cfi1513840/TideGauge/Tide Gauge Construction.pdf

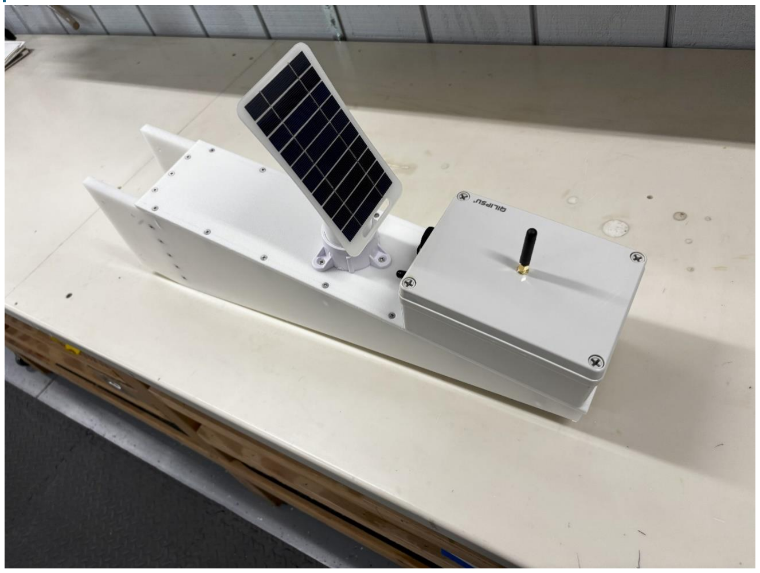
[picture p1: figure]

Ken Howell
1-18-2025

# Tide Gauge Project

## Construction & Deployment

## Contents

## Introduction

The tide gauge is constructed using low-cost components to provide a system to measure and track the tide level at coastal locations. Water-level detection is performed by an ultrasonic (https://maxbotix.com/products/mb7388?_pos=1&_psq=mb7388&_ss=e&_v=1.0) measurement sensor mounted on a small platform, along with a solar panel and LoRa transmitter (https://heltec.org/project/htcc-ab02/) module. The unit is independent of shore power and will operate under normal conditions through all seasons of the year. The platform is intended to be mounted at a dockside location, extending outward about 15”, in a manner that will ensure a clear vertical path from the sensor to the water level under all tidal conditions. The platform is constructed using HDPE material and stainless-steel fasteners to withstand the rigors of the coastal environment. The electronic components are housed within a weatherproof plastic enclosure. The receiving part of the tide gauge should be located within line-of-sight of the transmitting sensor, at distances up to ¼ mile. The receiving location should have access to the internet to provide the necessary online services required by the system. The receiving part of the tide gauge consists of a LoRa receiver (https://heltec.org/project/wifi-lora-32-v3/) and a Raspberry Pi (https://www.amazon.com/Raspberry-Model-2019-Quad-Bluetooth/dp/B07TC2BK1X?th=1) processor to receive and process the measured tide levels, which are then stored in an InfluxDB (https://www.influxdata.com/) database to provide current and historical data access online.
This document describes the fabrication of the tide gauge sensor and transmitting component, and provides instructions for the installation and configuration of all electronic components required to operate the tide gauge.

## Constructing the Platform

## Cutting HDPE to form platform components

The Platform HDPE side supports are cut from ½” material. The overall length of the platform is 24”. The supports are angled from 8” on the wide end to 1” on the narrow end. The wide end can be squared off to a distance of 3 ½” from the end. A plywood jig can be used to maintain a straight cut with the table saw. The bulkhead is cut from ½” material to the dimensions of 3 ½” x 6 ½”. The saw blade should be fine tooth for cutting the HDPE material. The top surface of the platform is cut from ¼” stock to the dimensions of 4 ½” x 20 ½”. The width of the top surface is sized to accommodate the size of the dock mounting post.

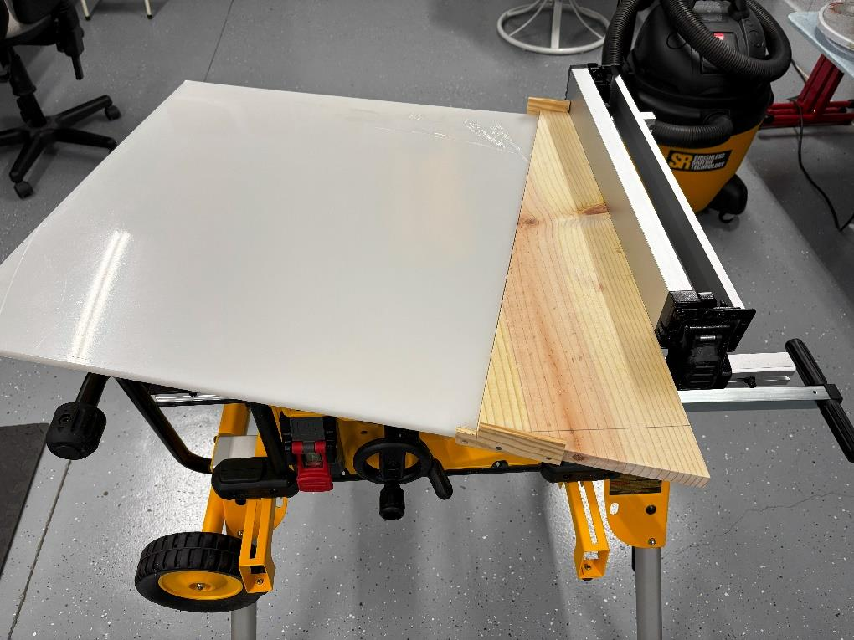
[picture p2: figure]

## Lay Out Hole Patterns

Using a sharpie and straightedge, layout the hole pattern on the side supports. Maintain the top and bottom edge distance as shown. The holes that attach the supports to the bulkhead are at approximately 1” intervals. The bulkhead is attached 3 ½” from the end of the support, which allows mounting on a compatible dockside railing post. To ensure exact orientation, drilling and countersinking should be performed using a drill press. Drill the bulkhead attachment holes using a #31 drill. The larger post/platform mounting holes are drilled using a 15/64” drill to
accommodate the #14 post mounting screws. When countersinking, set the microstop countersink on the light side to start with and progressively add depth until the head of an installed #8 deck screw rests just below the surface of the material.

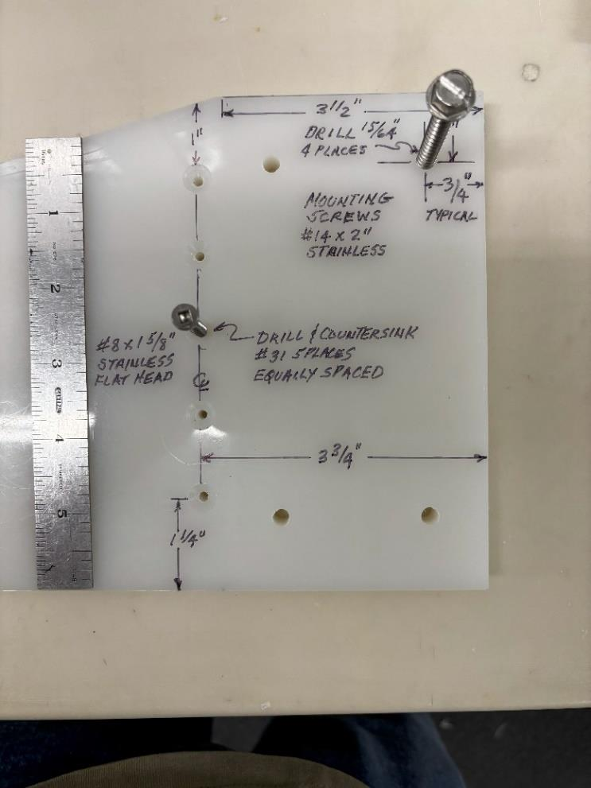
[picture p3: figure]
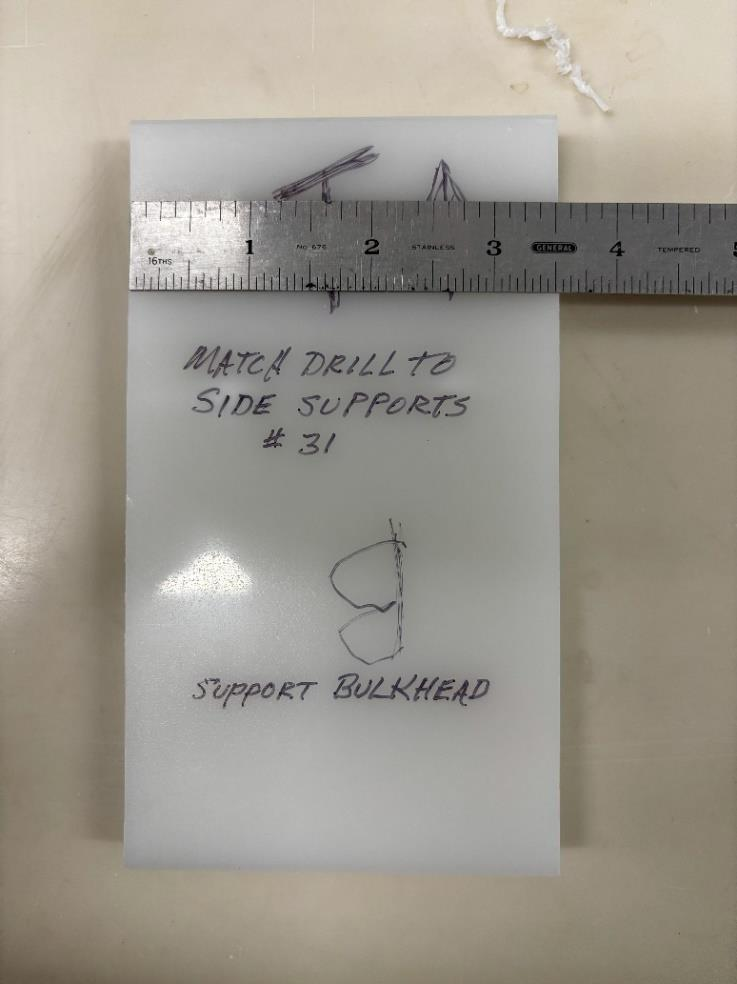
[picture p4: figure]

Note: Sharpie scribe marks and notation can be easily removed with denatured alcohol.

## Assemble Support Structure

With a sharpie, draw vertical lines on the side edges of the bulkhead in the exact center of the material. Clamp the supports and bulkhead assembly together on a flat surface, squaring the bulkhead and ensuring that the predrilled holes in the supports are centered over the bulkhead lines. Using a hand-operated electric drill, carefully match drill the bulkhead to a depth of 1 ½” with a #31 drill. Assemble the platform supports and
bulkhead using #8 x 1 5/8 flathead

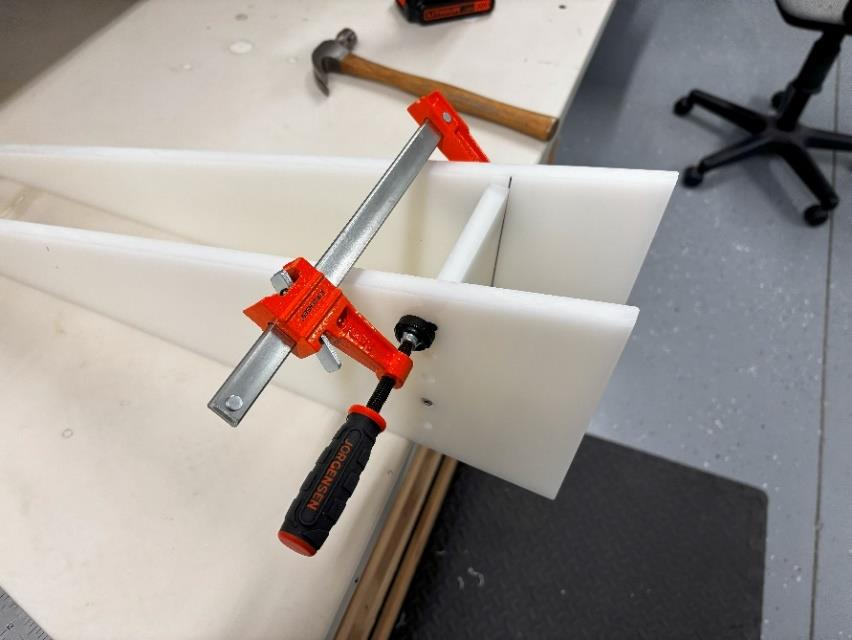
[picture p5: figure]

deck screws.

## Prepare Platform Surface

Layout the hole pattern on the platform top surface ¼” HDPE panel. The holes are spaced about every 3” and should align exactly with the center of the underlying supports. This distance can be exactly determined by measuring across the supports at the bulkhead, from the leading edge of one support to the leading edge of the other. This is the dimension that should be maintained on the top support surface between the scribed lines, with the lines being parallel and equidistant from the edges. The electronics enclosure will be mounted centered at the front of the platform with the forward edge of the enclosure about ¼ - ½” back from the forward edge of the platform. Locate and mark the mounting holes for the equipment enclosure. Note: the holes for the enclosure need to be located precisely as there is minimal edge

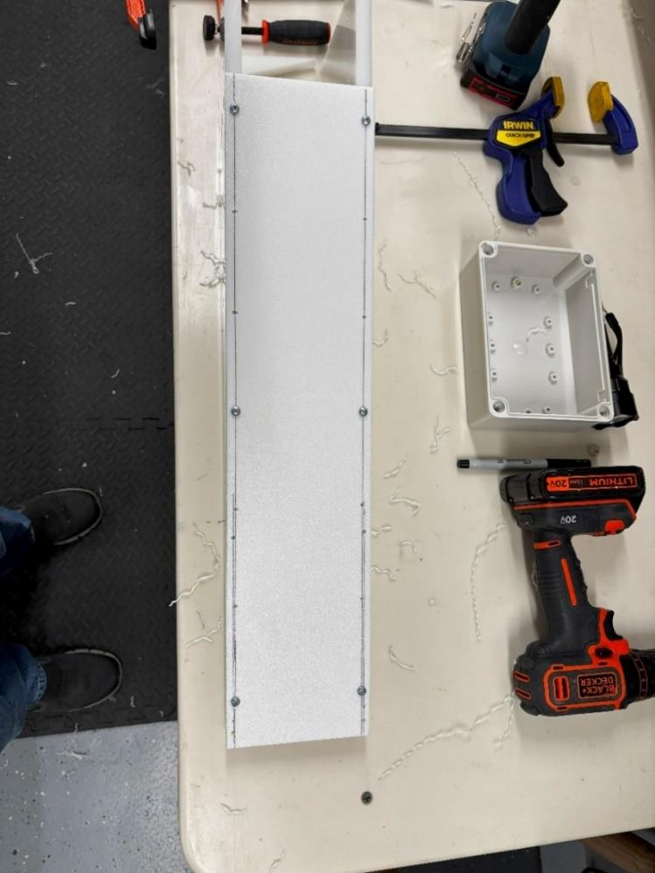
[picture p6: figure]

clearance on the platform surface. Drill and countersink all holes except for the enclosure mounting holes. Although not shown in the photo, there should also be three holes joining the top surface to the bulkhead.

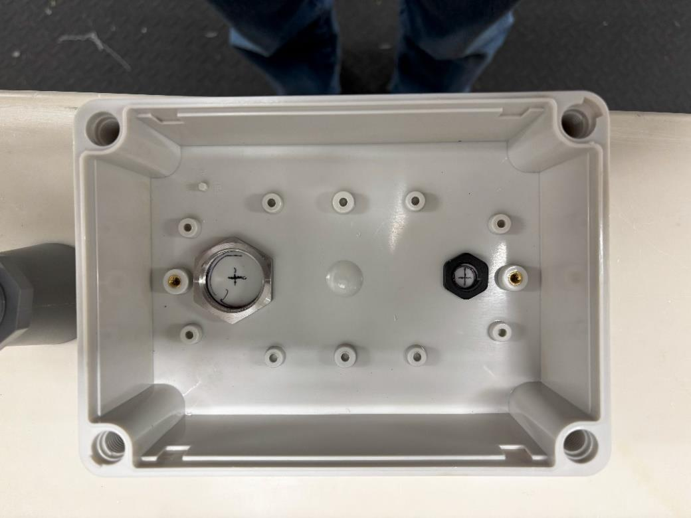
[picture p7: figure]

## Prepare Electronics Enclosure

Layout the holes for the sensor and solar panel wiring on the bottom of the electronics enclosure. Drill 1/8” pilot holes through the bottom of the enclosure. Then install the subpanel and back drill the subpanel through the pilot holes. Finally, while the enclosure is clamped or screwed in place on the platform, drill completely through the subpanel, enclosure and platform mounting surface. Disassemble and enlarge the holes as appropriate.
Note: the enclosure comes with a perforated subpanel, however the hole spacing does not align properly with the mounting holes in either the CubeCell module or PC board. To remedy this, the holes in the existing subpanel can be filled with an epoxy filler, or a new subpanel can be fabricated from 1/8” plastic sheet, using the existing subpanel as a template. For this installation, an epoxy filler was used, consisting of a mixture of West System epoxy and hardener with the addition of microspheres to thicken the mixture to the proper consistency.

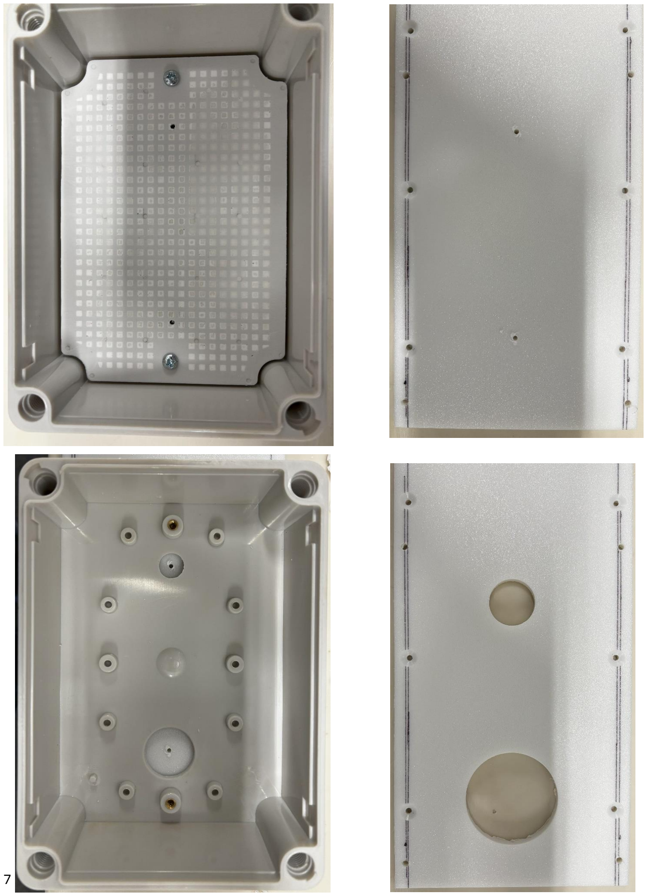
[picture p8: page 8]

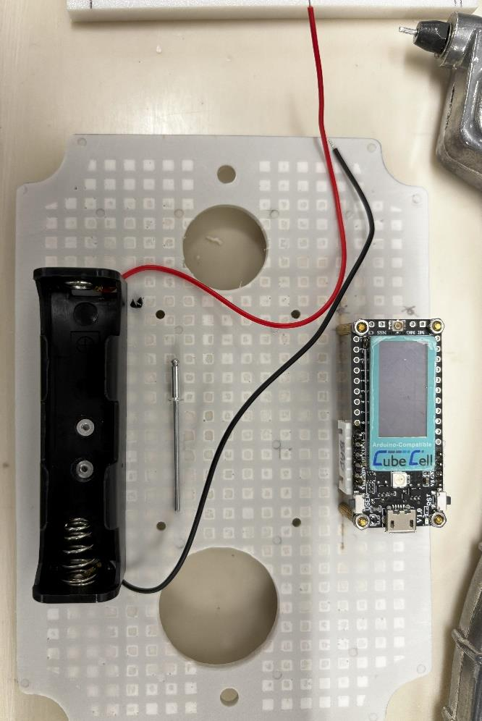
[picture p9: figure]

## Subpanel Component Installation

On the subpanel, layout the locations for the CubeCell, battery holder, and PC board. This can be facilitated by creating templates to transfer the exact hole locations to the subpanel.
Attach the battery holder with flush style pop rivets or other means. If using rivets, the holes in the battery holder should be countersunk. This can be easily accomplished with a small hand countersink tool. The CubeCell and PC board are mounted using 2mm brass standoffs and hardware.
Solder on the CubeCell headers and connect the pre-fabricated CubeCell battery input lead before mounting it on the subpanel. Note: the CubeCell in the top photo was used for layout purposes and does not have the headers installed.
The mounting holes on the CubeCell have minimal radial clearance. For this reason, brass standoff connectors were used to secure the CubeCell.

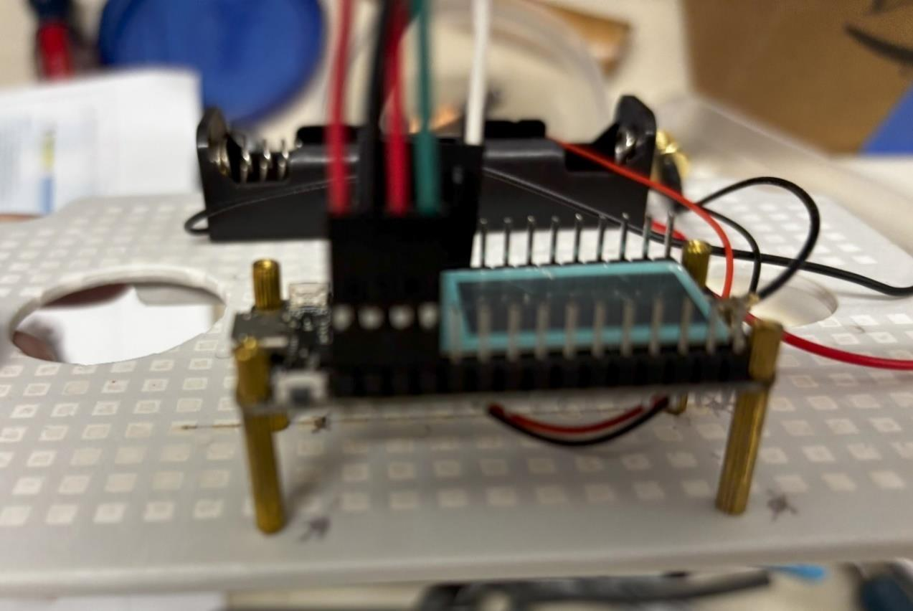
[picture p10: figure]
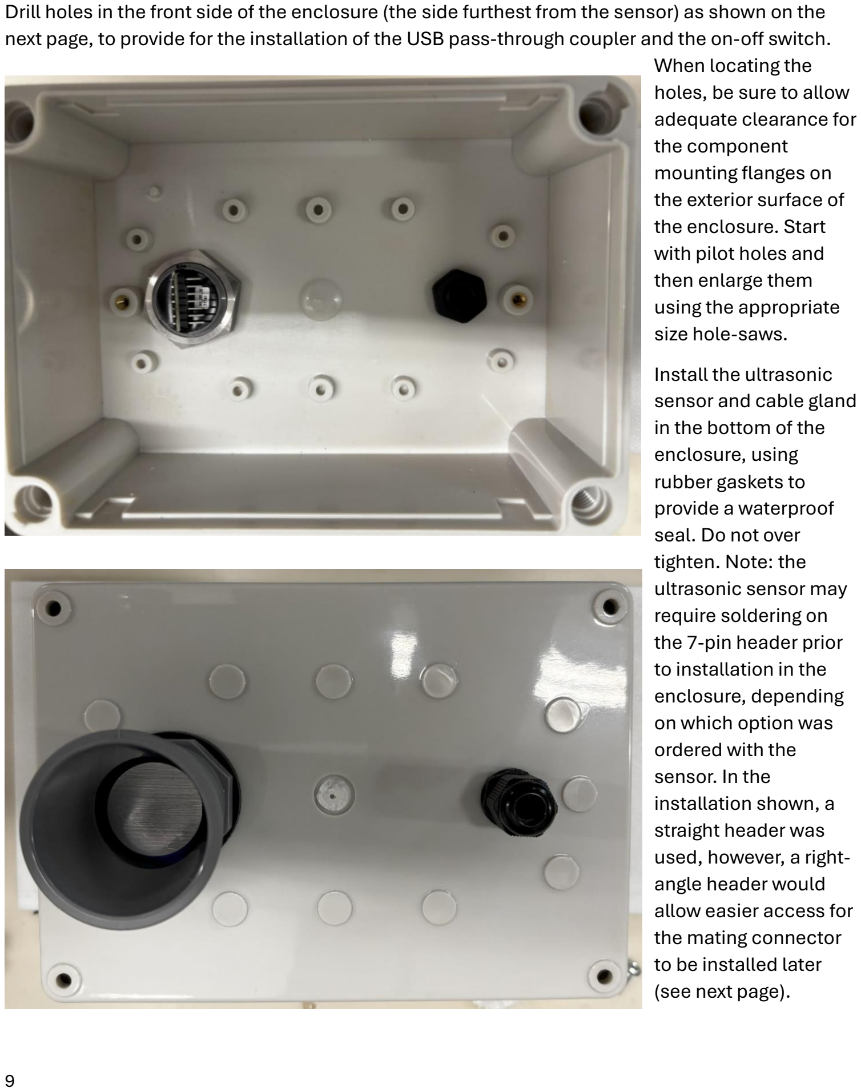
[picture p11: page 10]

Drill holes in the front side of the enclosure (the side furthest from the sensor) as shown on the next page, to provide for the installation of the USB pass-through coupler and the on-off switch. When locating the
holes, be sure to allow
adequate clearance for
the component
mounting flanges on
the exterior surface of
the enclosure. Start
with pilot holes and
then enlarge them
using the appropriate
size hole-saws.
Install the ultrasonic
sensor and cable gland
in the bottom of the
enclosure, using
rubber gaskets to
provide a waterproof
seal. Do not over
tighten. Note: the
ultrasonic sensor may
require soldering on
the 7-pin header prior
to installation in the
enclosure, depending
on which option was
ordered with the
sensor. In the
installation shown, a
straight header was
used, however, a right-angle header would
allow easier access for
the mating connector
to be installed later
(see next page).

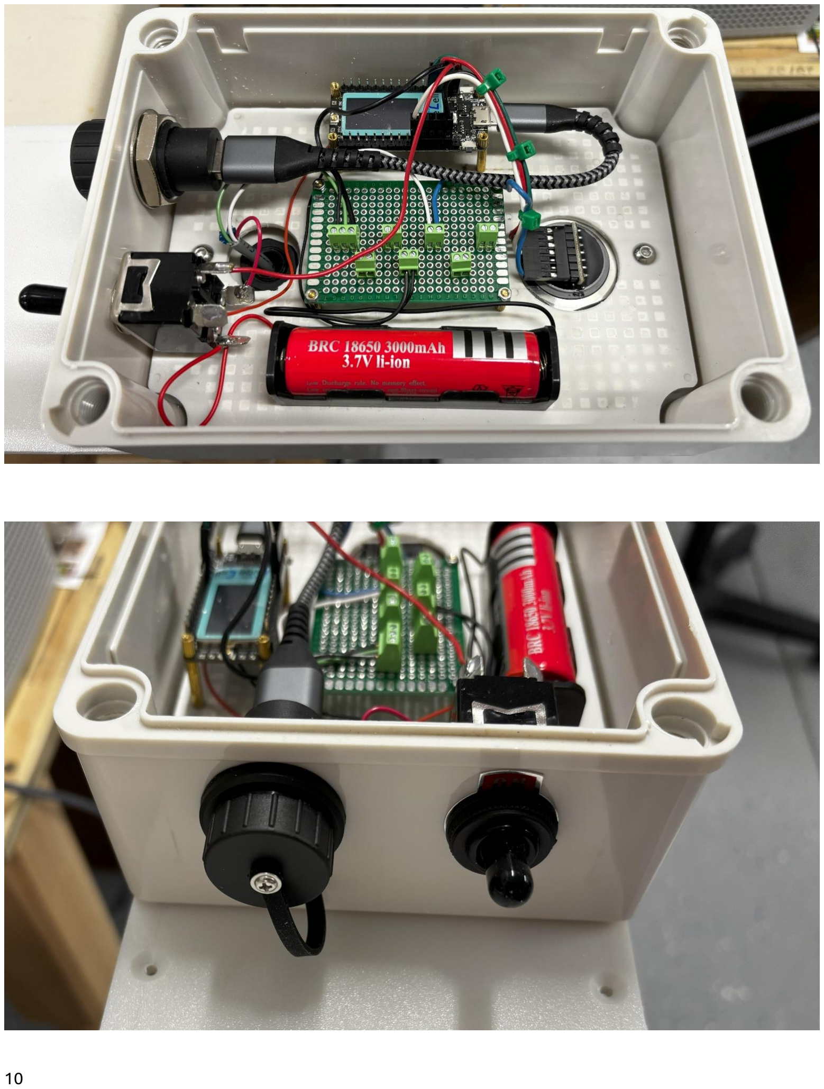
[picture p12: page 11]

## Component Wiring

The PCB and screw terminals are used to facilitate component replacement, if required. Screw terminal leads have soldered jumpers installed on the opposite side of the board. Note that spare terminals were installed but not used. These can be omitted and a smaller PCB used, if desired. Fabricate a wiring harness to interconnect the MaxBotix sensor with the CubeCell. The harness has a 7-pin header connector on the sensor end, four-pin and five-pin connectors on the CubeCell end, and a single wire that will be attached to one of the 2-position screw terminals to interconnect the temperature sensor, which is installed under the platform. Note that not all header pins are used in the connectors. Refer to the Tide Gauge Wiring diagram below to determine the connector pinouts.

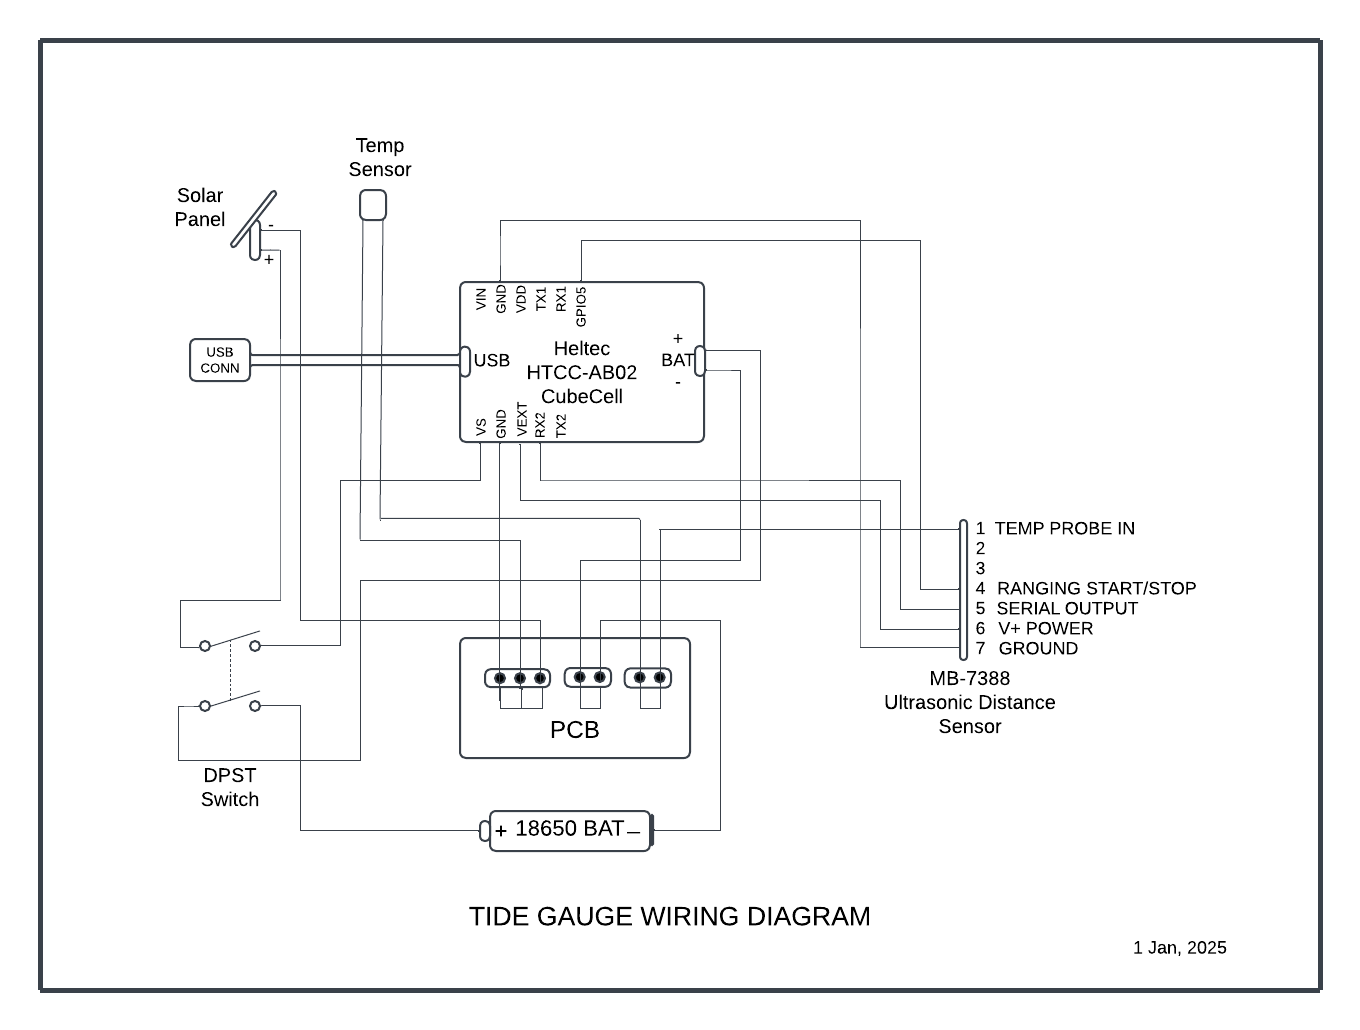
[picture p13: figure]

## Fabricate and Install Solar Panel

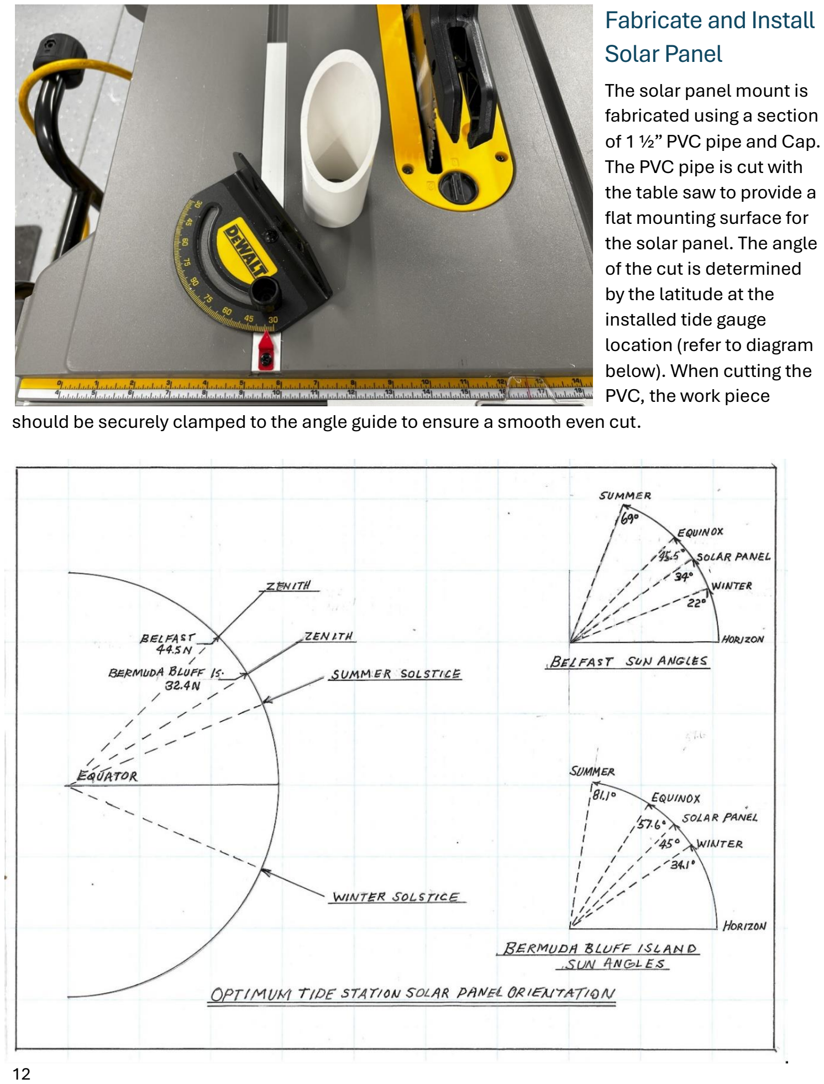
[picture p14: page 13]

The solar panel mount is
fabricated using a section of 1 ½” PVC pipe and Cap.
The PVC pipe is cut with
the table saw to provide a flat mounting surface for
the solar panel. The angle of the cut is determined
by the latitude at the
installed tide gauge
location (refer to diagram below). When cutting the
PVC, the work piece
should be securely clamped to the angle guide to ensure a smooth even cut.

## Attaching Solar Panel to Mounting Post

Note: the solar panel is angled about 12 degrees towards the winter solstice sun angle to compensate for the reduction is winter daylight hours.
To prepare the solar panel for installation, the existing cable should be cut about 8” from the panel and a Molex 2-position micro-fit connector installed. The panel is fitted to the PVC with the panel connections closest to the bottom of the angular cut.
The solar panel is attached to the PVC pipe with plastic glue or epoxy. For this installation, a mixture of West System Epoxy and Hardener was used. To facilitate the attachment, the pipe should be clamped in a vice with the mounting surface adjusted exactly level in both dimensions. Using a cotton swab or similar, the mounting surface of the PVC is liberally coated with the glue or epoxy mixture. This will help to ensure a weatherproof connection between the two parts. Carefully place the panel on the PVC and make sure it is aligned exactly with the pipe (the jaws of the vice can be used for this purpose). Note that the panel is offset vertically such that the panel

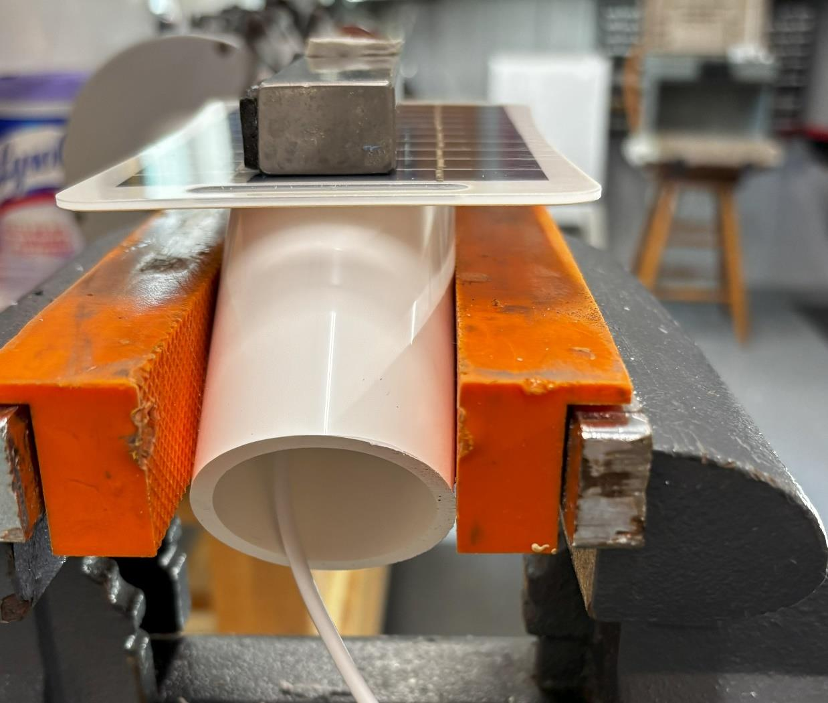
[picture p15: figure]

connections are just enclosed within the bottom of the oval mounting surface. Place a small weight on the top of the panel to ensure a good bond while the epoxy is setting up. Allow 24 hours for setup. In the photo, a small bucking bar is used to secure the panel.

## Install Solar Panel Mounting Base

Drill a 1/8” pilot hole in the PVC cap exactly centered within the inside diameter. Locate the cap on the platform surface about 4 inches from the edge of the enclosure to ensure adequate solar illumination without shadowing. Use the pilot hole to drill through the platform. Enlarge the holes to 1”. Drill the 1/8” mounting holes in the platform surface using the cap as a template. Install the cap using #8 x ½” sheet metal screws.

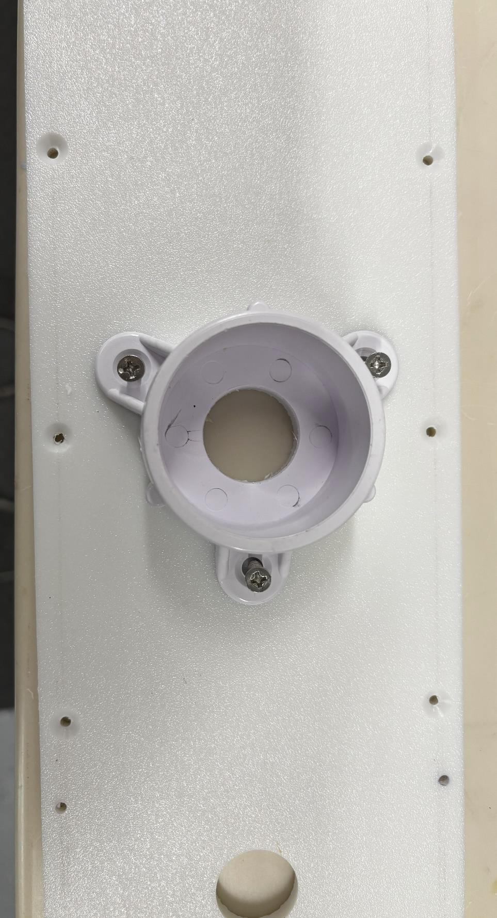
[picture p16: figure]

## Prepare and Install Lower Junction Box

Prepare the small junction box for installation. The box will be attached to the underside of the platform surface, with the center of the box exactly aligned with the PVC cap above. Drill a ½” hole in the bottom center of the box to accommodate a cable gland. With the gland installed, the box should be positioned such that the gland is centered in the PVC cap/platform relief hole. Drill four 5/64” mounting holes as shown in the photo to attach the box to the bottom of the platform surface. Countersink the mounting holes. Drill ½” holes in each side of the box as shown to accommodate the wiring from the temperature sensor and the wiring to the enclosure. Install the cable glands and attach the box to the underside of the platform using #4 x ½” flat head wood screws.

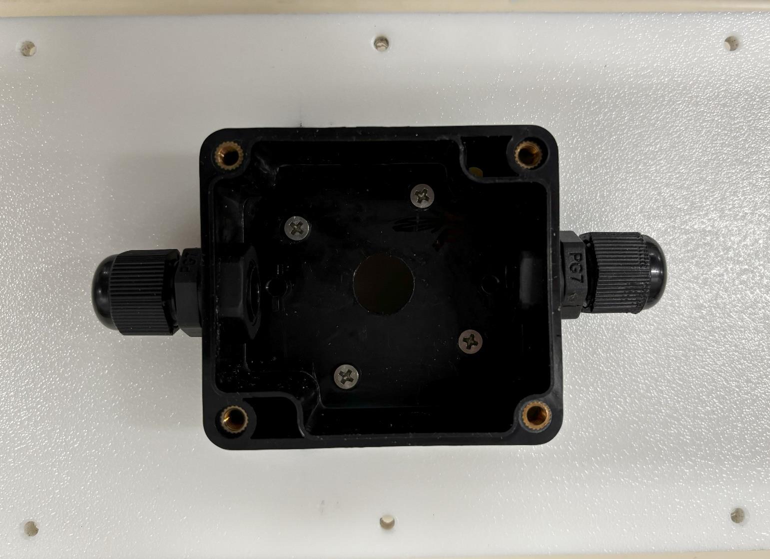
[picture p17: figure]

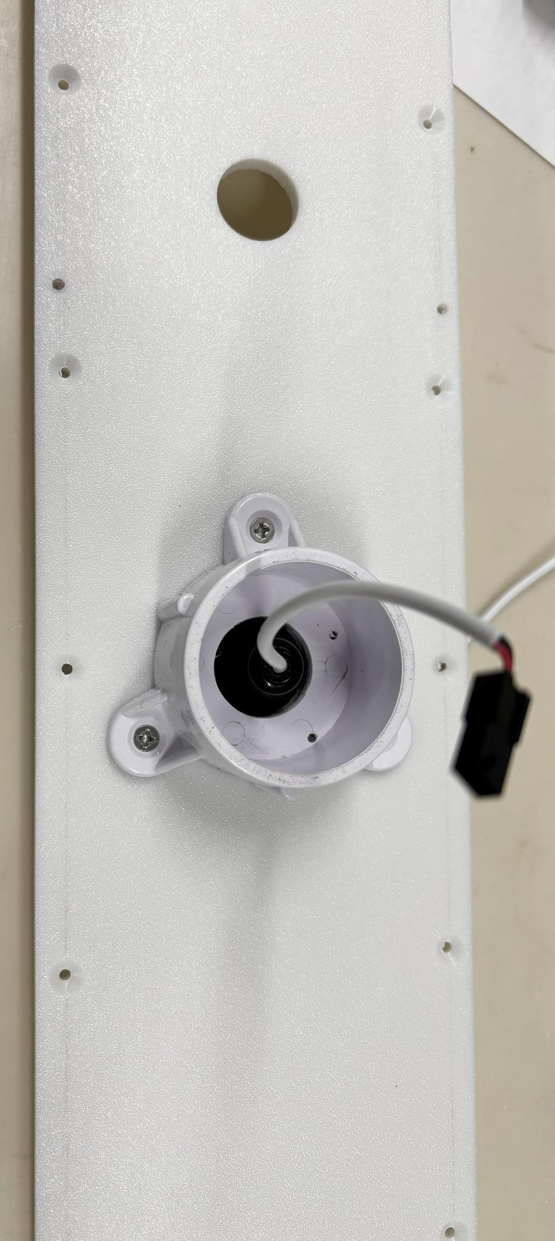
[picture p18: figure]

## Fabricate Solar Panel Connector Cable

Install a 2-conductor cable to connect the solar panel to the interconnect at the junction box. Leave a few inches extending above and below the gland. The end of the cable on the top side has the Molex micro-fit plug installed to mate with the connector on the solar panel. Having the connector in this position will allow easy replacement of the solar panel, if required.
The solar panel is attached by sliding the PVC post into the cap and seating it as far in as possible. A small amount of lubricant is helpful in seating the post. Later, when the sensor is installed at the dock location, a compass will be used to ensure that the solar panel is oriented so that it is pointing towards South. Once the orientation is established, a small hole can be drilled through the post and cap and a “keeper” screw installed.

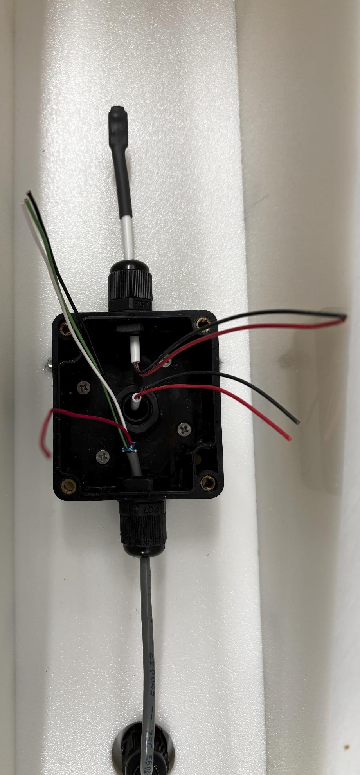
[picture p19: figure]

## Install Temperature Sensor and Interconnect Wiring

Solder the temperature sensor on a short piece of 2-conductor cable and cover the sensor and cable end with a section of shrink tubing. Run the cable through the gland as shown. The sensor and cable are supported by the cable gland and require no further support. Strip back the cable sheath leaving a few inches of wire exposed.
Run the 4-conductor interconnect cable from the junction box to the enclosure through the cable glands. Strip back the cable sheath as above. Splice the solar panel and temperature sensor wiring to the interconnect cable in accordance with the wiring diagram. For this installation, Hilitchi wire connectors (https://www.amazon.com/Connector-Uvital-Waterproof-Gel-Filled-Connectors/dp/B07Z7NY6BN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) were used.

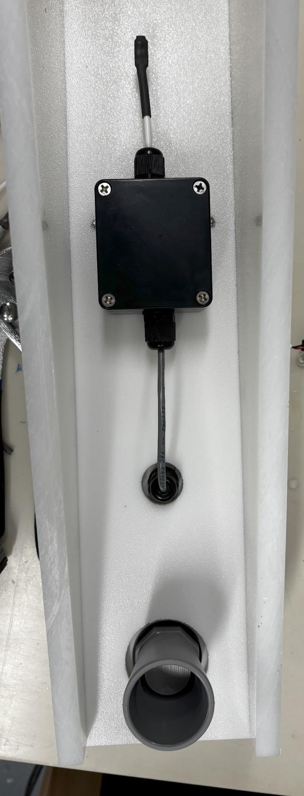
[picture p20: figure]

## Underside view of finished Tide Gauge

## Programming the Heltec LoRa Modules

## Module Description

The Heltec HTCC-AB02 CubeCell and WiFi LoRa 32(v3) modules provide the capability of reading, processing, transmitting and receiving tide level measurements to support the tidal data acquisition process. These modules have a broad range of capabilities, however, only the functions associated with the serial interface, processing, and transmitting LoRa data are utilized. To conserve power the OLED display and WiFi functions will remain inactive.

## Module Interconnectivity

The HTCC-AB02 CubeCell connects to the ultrasonic sensor via its serial interface to read, process and forward distance (water level) measurement data to the receiving WiFi LoRa 32(V3) module. To conserve power, the sensor is operated in the “triggered” mode and is activated for only 20 seconds out of every minute, with the remainer of the time being placed in the “sleep” mode. During the active period, 20 measurements are taken at one second intervals. This sampling scheme helps to ensure an accurate measure of the tide level, while averaging out the effects of chop or wave action. The built-in triggering function is activated by applying a signal on Pin 4 on the sensor. Measured values in the form of text messages are output on the sensor serial output pin 5. The CubeCell performs error checking and filtering of the data prior to LoRa transmission. Measurements are transmitted in the form of text-formatted packets containing the measurement values and associated meta data, such as battery voltage, etc.

## Module Processing

The receiving WiFi LoRa 32(V3) module receives and outputs the data to a Raspberry Pi 4 (RPi4) processor, which in turn, writes the data to an InfluxDB database for both local and online storage. Note that the HTCC-AB02 CubeCell module is normally capable of providing both the LoRa transmit and receive capability. However, a problem was discovered which caused the USB interface between the receiving CubeCell and the RPi4 to stop functioning at random intervals. This problem required manual rebooting or restarting the RPi4. The problem was alleviated by substituting the WiFi LoRa 32(V3) module to perform the receiving function.

## The Arduino IDE

The Heltec units are among a variety of modules that are supported by the Arduino Integrated Development Environment (IDE). The Arduino IDE is open-source software that can be downloaded and installed under the Windows, Linux, or macOS operating systems. There are also pre-programmed libraries available to support both Heltec modules. During development of the tide gauge, certain incompatibilities were noted between the Heltec libraries and the latest IDE version 2.3.4. For this reason, it is recommended to download and install the IDE legacy version

2.3.2, which can be found at the URL Release 2.3.2 · arduino/arduino-ide · GitHub. (https://github.com/arduino/arduino-ide/releases/tag/2.3.2) The version corresponding to the platform in use (PC, Mac) should be downloaded and installed.

## Module Software Program Format

The software programs that run on the Heltec devices are referred to as “sketches”. These are C language programs that have the unique file type of “.ino”. Once a sketch has been prepared, it is compiled by the IDE using the appropriate library files and downloaded to the Heltec module via the USB connection between the IDE platform and the module.

## Module Framework and Library Description

When configuring the Arduino IDE, the device framework and library modules required to support each specific device are downloaded. Refer to Heltec ESP32 Series Quick Start — esp32 latest documentation (https://docs.heltec.org/en/node/esp32/esp32_general_docs/quick_start.html) for additional information.
For the HTCC-AB02 CubeCell and WiFi LoRa 32(v3) modules, the supporting framework and libraries listed below are required. Some of the libraries may not relate directly to the functions utilized but are required as dependencies of other library modules. The Arduino IDE incorporates two different levels of device support. The device framework is provided by the Boards Manager, whereas additional functional device support is provided by the Library Manager. The Boards and Library Manager utilities are accessed via the IDE menu options.

## Module Framework and Library Installation

The Arduino IDE File->Preferences menu option is used to download the CubeCell Development framework and the WiFi LoRa ESP32(v3) framework. This is accomplished by adding the following URL’s to the Additional boards manager URL’s:
1. https://github.com/HelTecAutomation/CubeCell-Arduino/releases/download/V1.5.0/package_CubeCell_index.json. (https://github.com/HelTecAutomation/CubeCell-Arduino/releases/download/V1.5.0/package_CubeCell_index.json)
2. https://resource.heltec.cn/download/package_heltec_esp32_index.json
When the URL’s have been added, the OK button is selected to initiate the download.
Once the download is complete, the Boards Manager panel should show entries for “CubeCell Development Framework by Heltec” and “Heltec ESP32 Series Dev-boards by Heltec”, both of which are then installed with the corresponding INSTALL button.
The libraries are then installed through the Arduino IDE Library Manager. From the Library Manager panel, search for and install the following:
1. ESP8266 and ESP32 OLED driver for SSD1306…
2. Heltec ESP32 Dev-Boards by Heltec…
3. Heltec ESP8266 Dev-Boards by Heltec…
4. Heltec_ESP32_LoRa_v3 by Rop Gongrijp

5. Heltec_LoRa_OLED_Examples by GregLee
6. HotButton by Ron Gongrijp
7. RadioLib by Jan Gromes
Note: Items 6 and 7 are normally
downloaded as dependencies for other modules.

## Module Sketch, Board and Port Selection

With the framework and libraries installed, the Arduino IDE menu option Tools->Board can be selected to view a dropdown menu containing the board types. This menu is followed to select the board framework matching the connected board to be programmed.
The Arduino IDE menu option File->Examples can be used to load board-specific example sketches that are tailored to perform specific functions, for example LoRa transmit and receive. This is a good starting point for sketch development, and the way the tide gauge sketches were initially created.
When the USB connection has been established with the board, the appropriate Comm Port connection should be displayed on the pull-down in the board display area of the IDE.

## Appendix A – Tide Gauge – Parts List and Cost Analysis

Item Nbr | Description | Total Cost | Percentage used by project | Project Cost | Receiving Station
1 | 24" x 48" x 1/2" HDPE Panel (https://www.amazon.com/gp/product/B0CC58C836/ref=ppx_yo_dt_b_search_asin_title?ie=UTF8&th=1) | 87.99 | 25 | 22.00
2 | 24" x 48" x 1/4" HDPE Panel (https://www.amazon.com/gp/product/B0BYPD4XYV/ref=ppx_yo_dt_b_search_asin_title?ie=UTF8&th=1) | 65.99 | 25 | 16.50
3 | 24" x 24" x 1/8" Plastic Sheet (https://www.amazon.com/gp/product/B00BCPYPLM/ref=ppx_yo_dt_b_search_asin_title?ie=UTF8&psc=1) | 15.36 | 25 | 3.84
4 | #4 x 1/2" Flat Head Wood Screws (https://www.amazon.com/gp/product/B07H2ZJLCF/ref=ppx_yo_dt_b_search_asin_title?ie=UTF8&psc=1) | 12.31 | 10 | 1.23
5 | #8 x 1" Pan Head Sheet Metal Screws (https://www.amazon.com/gp/product/B01CEZSJB0/ref=ppx_yo_dt_b_search_asin_title?ie=UTF8&th=1) | 15.16 | 4 | 0.61
6 | #6 x 1 1/4" Deck Screws (https://www.amazon.com/gp/product/B018UPHUTU/ref=ppx_yo_dt_b_search_asin_title?ie=UTF8&psc=1) | 14.95 | 10 | 1.50
7 | #8 x 1 5/8" Deck Screws (https://www.amazon.com/gp/product/B0CVZSBWCN/ref=ppx_yo_dt_b_search_asin_title?ie=UTF8&psc=1) | 14.49 | 20 | 2.90
8 | #8 x 1/2" Flat Head Wood Screws (https://www.amazon.com/Screws-Phillips-Stainless-Quantity-Fastenere/dp/B01MCWTEX4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) | 14.48 | 3 | 0.43
9 | #14 x 2" Hex Washer Head Screws (https://www.amazon.com/Stainless-Washer-Drilling-Screws-Tapping/dp/B076BWXDD3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) | 15.99 | 20 | 3.20
10 | 3/32" Aluminum Blind Rivets (https://www.amazon.com/ALUMINUM-BLIND-COUNTERSUNK-031-125-PIECES/dp/B01MUF5Y0V?gQT=1) | 18.43 | 2 | 0.37
11 | QILIPSU Outdoor Junction Box (6.9"x4.9"x3") (https://www.amazon.com/gp/product/B0CSG54SYW/ref=ppx_yo_dt_b_search_asin_title?ie=UTF8&th=1) | 13.49 | 100 | 13.49
12 | Zulkit Project Box (2.48"x2.28"x1.38") (https://www.amazon.com/gp/product/B07SBWQL18/ref=ppx_yo_dt_b_search_asin_title?ie=UTF8&th=1) | 6.59 | 100 | 6.59
13 | QILIPSU 1/2" NPT Cable Glands (https://www.amazon.com/QILIPSU-Waterproof-Adjustable-Locknut-Diameter/dp/B07ZRH3V59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) | 8.99 | 33 | 2.97
14 | PVC Table Leg Cap (https://www.amazon.com/gp/product/B0CFLN8QG3/ref=ppx_yo_dt_b_search_asin_title?ie=UTF8&th=1) | 7.59 | 50 | 3.80
15 | PVC Pipe, 1 1/2" (https://www.amazon.com/gp/product/B085B4YW2T/ref=ppx_yo_dt_b_search_asin_title?ie=UTF8&psc=1) | 31.99 | 5 | 1.60
16 | Solar Panel (https://www.amazon.com/gp/product/B0CWGW8Q3D/ref=ppx_yo_dt_b_search_asin_title?ie=UTF8&psc=1) | 16.03 | 100 | 16.03
17 | MaxBotix MB7388 Ultrasonic Distance Sensor (https://maxbotix.com/products/mb7388) | 119.95 | 100 | 119.95
18 | Heltec HTCC-AB02 LoRa CubeCell Module (https://heltec.org/project/htcc-ab02/) | 15.50 | 100 | 15.50
18 | Heltec WiFi LoRa 32(V3) (https://heltec.org/project/wifi-lora-32-v3/) | 19.90 | 100 | | 19.90
19 | Raspberry Pi 4 (https://www.amazon.com/CanaKit-Raspberry-4GB-Starter-Kit/dp/B07V5JTMV9) | 119.99 | 100 | | 119.99
20 | Brass Standoff Kit (https://www.amazon.com/gp/product/B09X3F9D1D/ref=ppx_yo_dt_b_asin_title_o00_s00?ie=UTF8&th=1) | 15.99 | 5 | 0.80
21 | Printed Circuit Board (https://www.amazon.com/Rindion-Compatible-Prototype-Electronics-Soldering/dp/B0DBZ1BXFZ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) | 6.99 | 5 | 0.35
22 | 18650 Battery Holder (https://www.amazon.com/DIANN-10pcs-Battery-Holder-Single/dp/B0BJV7SK5D?s=electronics) | 5.99 | 10 | 0.60
23 | 18650 Battery (https://www.amazon.com/WZXLifeScult-Universal-Doorbells-Flashlights-Headlamps/dp/B0D479CCVK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) | 19.89 | 25 | 4.97
24 | Waterproof Double Pole, Single Throw Switch (https://www.amazon.com/gp/product/B082QNPQSW/ref=ppx_yo_dt_b_search_asin_title?ie=UTF8&psc=1) | 13.99 | 33 | 4.62
25 | Waterproof USB Coupler (https://www.amazon.com/gp/product/B09VNS64HM/ref=ppx_yo_dt_b_search_asin_title?ie=UTF8&th=1) | 16.99 | 100 | 16.99
26 | Micro USB to USB Cable, 6" (https://www.amazon.com/SUNGUY-Braided-Charging-Samsung-Android/dp/B0BHNVLW1Z) | 7.99 | 33 | 2.64
27 | Molex Micro-fit Receptacle, 2 position (https://www.digikey.com/en/products/detail/molex/0436450200/268974?s=N4IgTCBcDaIO4FsCMAOALAVgLQDsAmIAugL5A) | 0.31 | 100 | 0.31
28 | Molex Micro-fit Plug, 2 position (https://www.digikey.com/en/products/detail/molex/0436400201/268984?s=N4IgTCBcDaIO4FsCMAOArGgtAOwCYgF0BfIA) | 0.33 | 100 | 0.33
29 | Molex Micro-fit Connector Socket 20-24AWG (https://www.digikey.com/en/products/detail/molex/0430300009/252481) | 0.15 | 100 | 0.15
30 | Molex Micro-fil Connector Pin 20-24AWG (https://www.digikey.com/en/products/detail/molex/0430310009/252485) | 0.19 | 100 | 0.19
31 | Header Connector Kit (with crimping tool) (https://www.amazon.com/gp/product/B0C6PM9KGY/ref=ppx_yo_dt_b_search_asin_title?ie=UTF8&psc=1) | 26.99 | 5 | 1.35
32 | Screw Terminal Block Connectors (https://www.amazon.com/gp/product/B09F6TC7RP/ref=ppx_yo_dt_b_search_asin_title?ie=UTF8&psc=1) | 14.99 | 10 | 1.50
33 | Wire Connectors (https://www.amazon.com/Connector-Uvital-Waterproof-Gel-Filled-Connectors/dp/B07Z7NY6BN?th=1) | 14.99 | 2 | 0.30
34 | 22AWG Wire (https://www.amazon.com/Electric-Flexible-Silicone-different-Electronic/dp/B07G2JWYDW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) | 15.19 | 2 | 0.30
Totals | 796.14 | 267.88 | 139.89

## Appendix B - Recommended Tools

1. Good Quality Soldering Iron & Solder
2. Table Saw
3. Drill Press
4. Cordless/Electric Hand Drill
5. Microstop and Hand Countersinking Tools
6. Woodworking Clamps
7. Hand Tools, Screwdrivers, Pliers, Cutters, etc.
8. Appropriate Size Drill Bits, Hole Saw and Drive Bits (Square & Phillips)
9. Hand Rivet Puller

## Appendix C – CubeCell Pinout Diagram

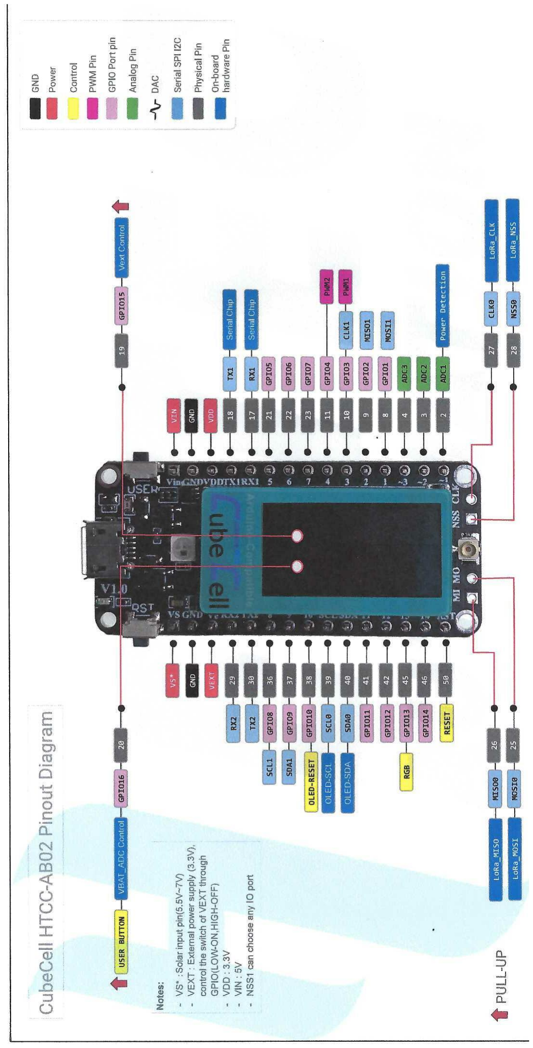
[picture p21: figure]

## Appendix D - MaxBotix Sensor Pinout

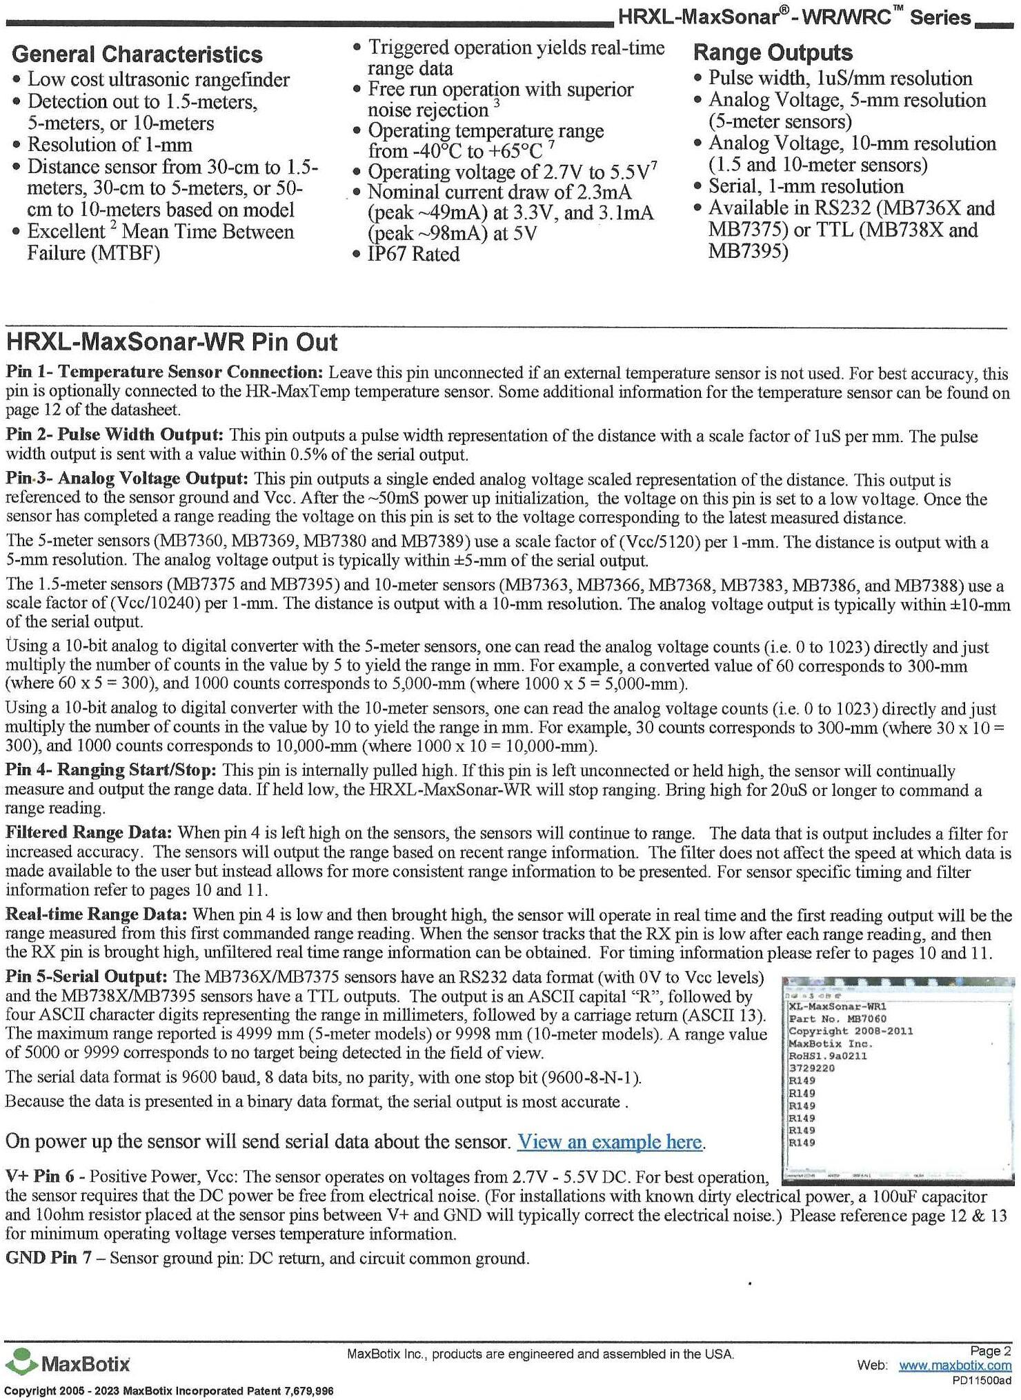
[picture p22: figure]
