cfi1513840/TideGauge/(commit log)

2025-01-27 Update README.md
    Added Arduino sketch files
2025-01-27 Delete tidetx.ino
    Wrong file uploaded
    [tidetx.ino]
2025-01-27 Add files via upload
    Arduino transmit sketch
